Bodensteiner23/Weather_Station/BOMs/bom_RTC_Module.csv

Designator | Footprint | Quantity | Value | LCSC Part #
BT1 | BatteryHolder_LINX_BAT-HLD-012-SMT | 1 | MY-1220-03
C1, C2 | 0805 | 2 | 1uF/10V
C3 | 0603 | 1 | 100nF/10V
C4, C5 | 0603 | 2 | 12p5/10V
D1 | D_SOD-123 | 1 | MM1Z4V7
F1 | 0603 | 1 | F0603FA0500V063TM
J1 | PinHeader_1x06_P2.54mm_Horizontal | 1 | DZ254W-11-06-65
R1, R2, R3, R4 | 0603 | 4 | 4k7
U2 | SOIC-8_3.9x4.9mm_P1.27mm | 1 | PCF8563T
U3 | SOT-23-3 | 1 | XC6206P332MR-G
Y1 | Crystal_SMD_MicroCrystal_CC7V-T1A-2Pin_3.2x1.5mm | 1 | Q13FC13500004
