Bodensteiner23/Weather_Station/BOMs/bom_Solar_Module.csv

Designator | Footprint | Quantity | Value | LCSC Part #
C1, C2 | 0805 | 2 | 22u/16V
C3, C4 | 0805 | 2 | 10u/16V
D1 | D_SMA | 1 | SS54
D2, D3 | 0603 | 2 | LED
F1 | 0603 | 1 | CFS06V3T1R0
J1, J3 | JST_EH_B2B-EH-A_1x02_P2.50mm_Vertical | 2 | B2B-PH-K-S
J2 | USB_C_Receptacle_GCT_USB4105-xx-A_16P_TopMnt_Horizontal | 1 | TYPE-C16PIN
L1 | L_Sunlord_MWSA0603S | 1 | MDA7030-150M
R1 | 0603 | 1 | 750k
R2 | 0603 | 1 | 100k
R3 | 0603 | 1 | 4k
R4 | 0603 | 1 | 1k
R6, R7 | 0603 | 2 | 5k1
R8 | 0603 | 1 | 1M
U1 | SOT-23-6 | 1 | MT3608
U2 | SOT-23-6 | 1 | TP4057
