Bodensteiner23/Weather_Station/Step Files/DMB0006A.stp

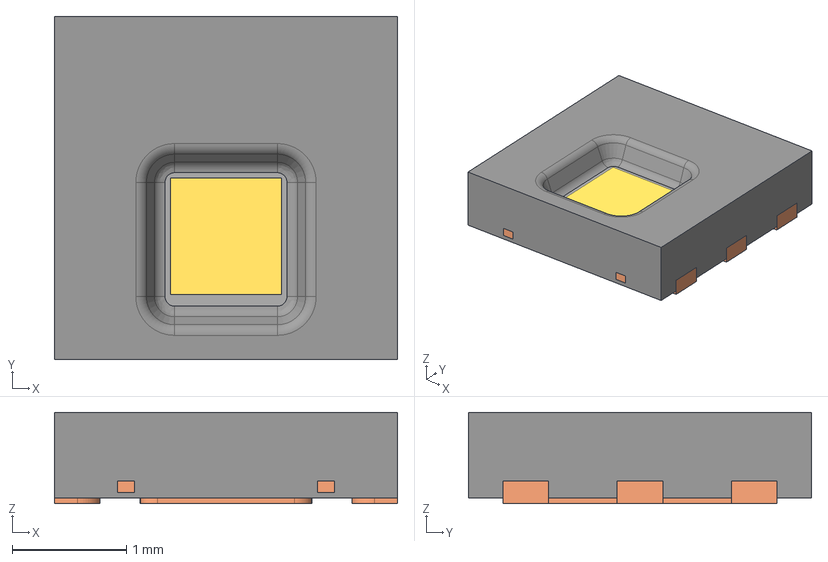
[picture p2: CAD file, 2024-08-01]
Step Files/DMB0006A.stp
3.00 x 3.00 x 0.8 mm
BODY-SON_118_1
FRAME-DMB0006A_77_1_1
FRAME-DMB0006A_77_2_1
FRAME-DMB0006A_77_3_1
FRAME-DMB0006A_77_4_1
FRAME-DMB0006A_77_5_1
FRAME-DMB0006A_77_6_1
FRAME-DMB0006A_77_7_1
PIN1-ID_16_1
DIE_1_1
