Bodensteiner23/Weather_Station/Solar Module/V1.0/Solar_Module.kicad_pcb

## KiCad design Solar Module/V1.0/Solar_Module.kicad_pcb (2024-08-16)

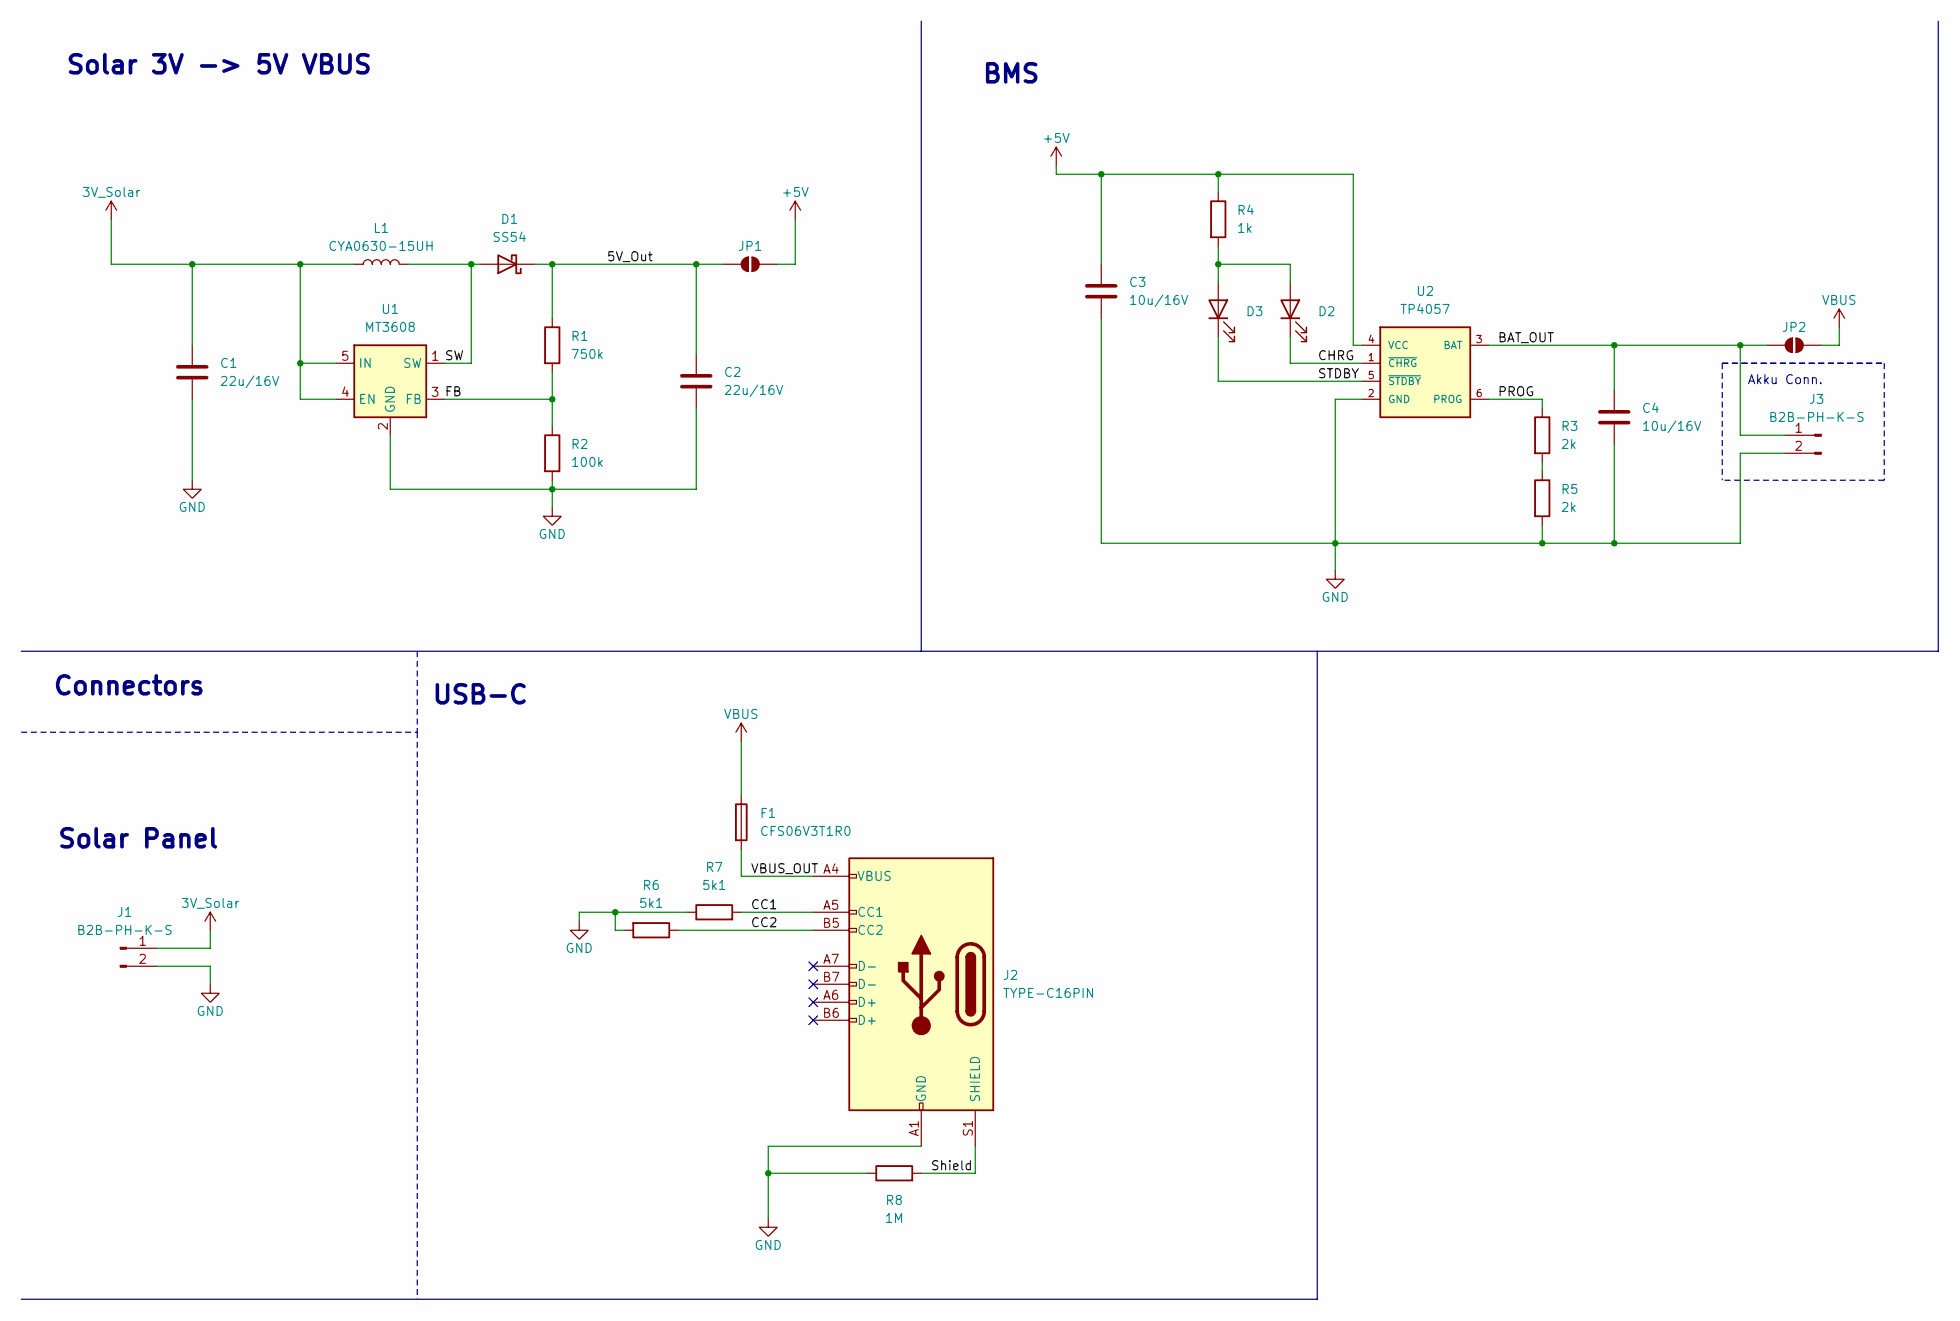
[picture p3: schematic Solar_Module.kicad_sch]

Parts:
C1, C2: 22u/16V; C_0805_2012Metric
C3, C4: 10u/16V; C_0805_2012Metric
D1: SS54; D_SMA
D2: KT-0603G; LED_0603_1608Metric
D3: KT-0603R; LED_0603_1608Metric
F1: CFS06V3T1R0; Fuse_0603_1608Metric
J1, J3: B2B-PH-K-S; JST_EH_B2B-EH-A_1x02_P2.50mm_Vertical
J2: TYPE-C16PIN; USB_C_Receptacle_GCT_USB4105-xx-A_16P_TopMnt_Horizontal
JP1, JP2: SolderJumper_2_Open; SolderJumper-2_P1.3mm_Open_TrianglePad1.0x1.5mm
L1: CYA0630-15UH; L_Chilisin_BMRx00060615
R1: 750k; R_0603_1608Metric
R2: 100k; R_0603_1608Metric
R3, R5: 2k; R_0603_1608Metric
R4: 1k; R_0603_1608Metric
R6, R7: 5k1; R_0603_1608Metric
R8: 1M; R_0603_1608Metric
U1: MT3608; SOT-23-6
U2: TP4057; SOT-23-6

Connections:
3V_Solar: C1.1, J1.1, L1.1, U1.4 (EN), U1.5 (IN)
+5V: C3.1, JP1.2 (B), R4.1, U2.4 (VCC)
/5V_Out: C2.1, D1.1 (K), JP1.1 (A), R1.1
/BAT_OUT: C4.1, J3.1, JP2.1 (A), U2.3 (BAT)
/CC1: J2.A5 (CC1), R7.2
/CC2: J2.B5 (CC2), R6.1
/CHRG: D2.1 (K), U2.1 (~CHRG)
/FB: R1.2, R2.1, U1.3 (FB)
/PROG: R3.1, U2.6 (PROG)
/STDBY: D3.1 (K), U2.5 (~STDBY)
/SW: D1.2 (A), L1.2, U1.1 (SW)
/Shield: J2.S1 (SHIELD), R8.2
/VBUS_OUT: F1.2, J2.A4 (VBUS), J2.A9 (VBUS), J2.B4 (VBUS), J2.B9 (VBUS)
GND: C1.2, C2.2, C3.2, C4.2, J1.2, J2.A1 (GND), J2.A12 (GND), J2.B1 (GND), J2.B12 (GND), J3.2, R2.2, R5.2, R6.2, R7.1, R8.1, U1.2 (GND), U2.2 (GND)
unnamed: D2.2 (A), D3.2 (A), R4.2
unnamed: R3.2, R5.1
VBUS: F1.1, JP2.2 (B)

Notes on the sheet:
Solar Panel
Connectors
Akku Conn.
USB-C
BMS
Solar 3V -> 5V VBUS

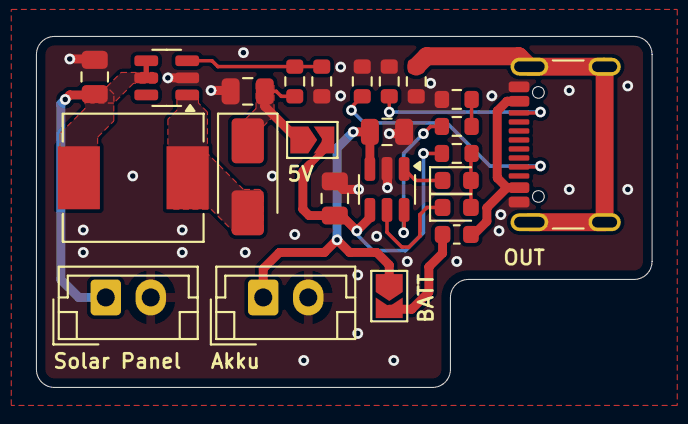
[picture p4: board Solar_Module.kicad_pcb from above]

Board: 4 copper layers, 34.2 x 19.5 mm, 24 parts (0 on the bottom side), 17 nets.
