Bodensteiner23/Weather_Station/Main PCB/V1.0/PCB_Files/Weather_Station.kicad_pcb

## KiCad design Main PCB/V1.0/PCB_Files/Weather_Station.kicad_pcb (2024-08-05, an earlier design)

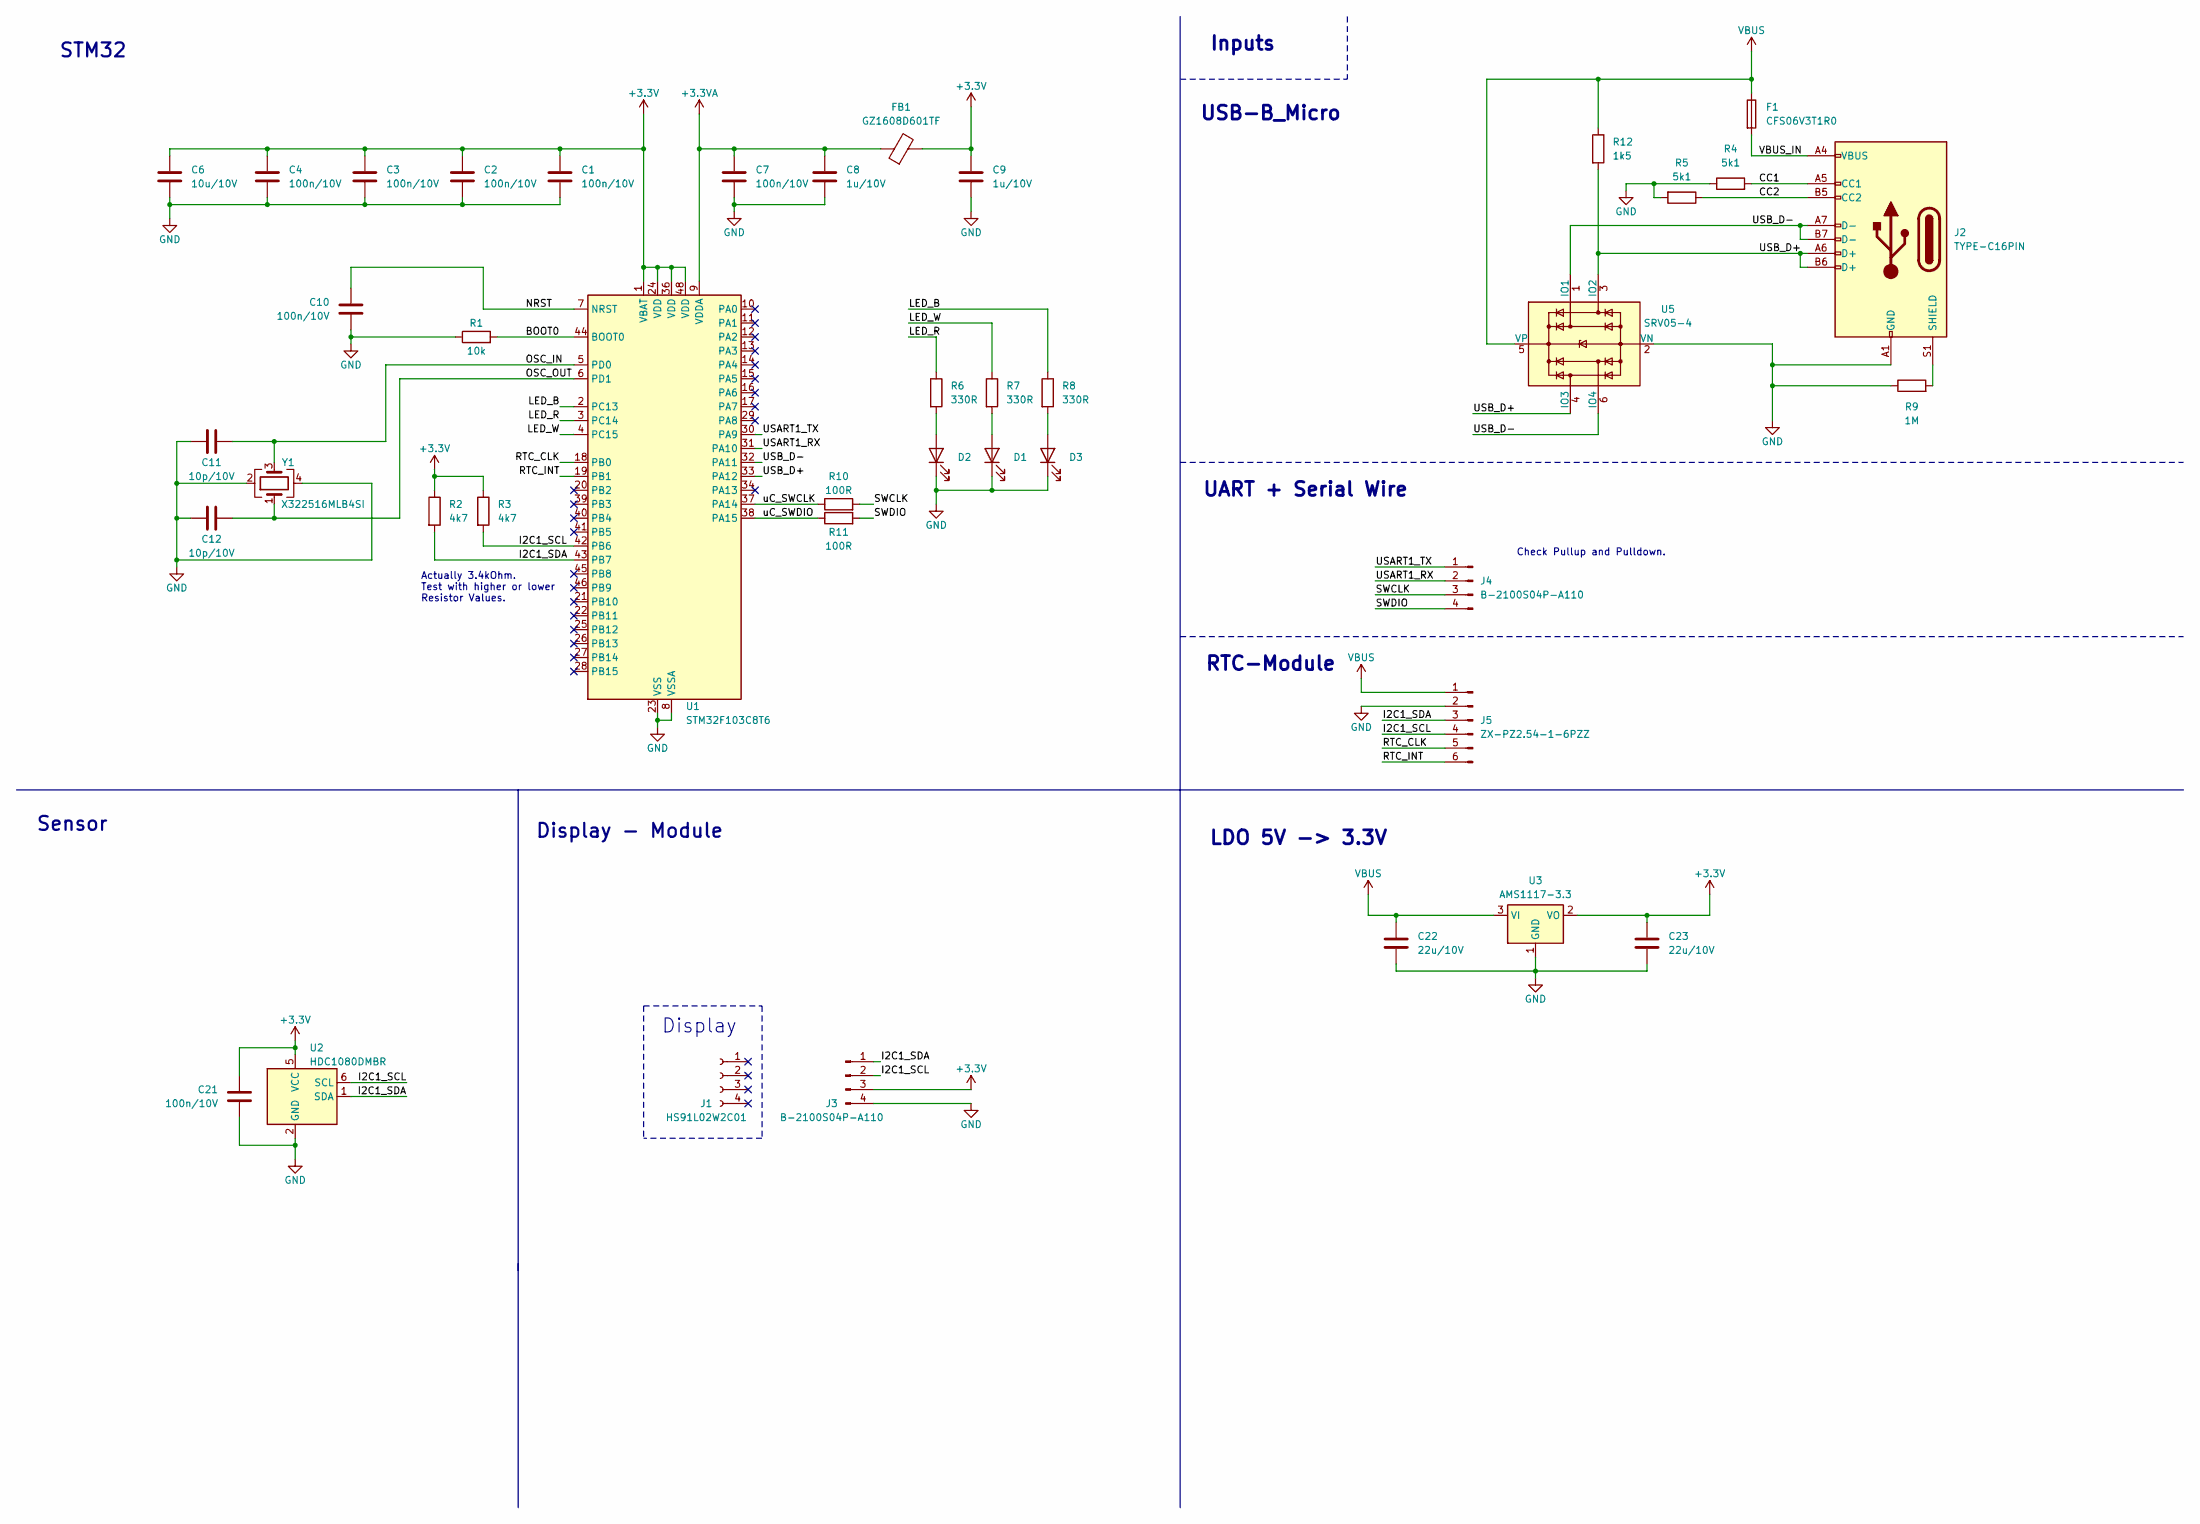
[picture p5: schematic Weather_Station.kicad_sch]

Parts:
C1, C2, C3, C4, C7, C10, C21: 100n/10V; C_0603_1608Metric
C6: 10u/10V; C_0805_2012Metric
C8, C9: 1u/10V; C_0603_1608Metric
C11, C12: 10p/10V; C_0603_1608Metric
C22, C23: 22u/10V; C_0805_2012Metric
D1: KT-0603W; LED_0603_1608Metric
D2: KT-0603R; LED_0603_1608Metric
D3: 19-217/BHC-ZL1M2RY/6T; LED_0603_1608Metric
F1: CFS06V3T1R0; Fuse_0603_1608Metric
FB1: GZ1608D601TF; L_1206_3216Metric
J1: HS91L02W2C01; C_0402_1005Metric
J2: TYPE-C16PIN; USB_C_Receptacle_GCT_USB4105-xx-A_16P_TopMnt_Horizontal
J3, J4: B-2100S04P-A110; PinHeader_1x04_P2.54mm_Vertical
J5: ZX-PZ2.54-1-6PZZ; PinHeader_1x06_P2.54mm_Vertical
R1: 10k; R_0603_1608Metric
R2, R3: 4k7; R_0603_1608Metric
R4, R5: 5k1; R_0603_1608Metric
R6, R7, R8: 330R; R_0603_1608Metric
R9: 1M; R_0603_1608Metric
R10, R11: 100R; R_0603_1608Metric
R12: 1k5; R_0603_1608Metric
U1: STM32F103C8T6; LQFP-48_7x7mm_P0.5mm
U2: HDC1080DMBR; Texas_PWSON-N6
U3: AMS1117-3.3; SOT-223-3_TabPin2
U5: SRV05-4; SOT-23-6
Y1: X322516MLB4SI; Crystal_SMD_3225-4Pin_3.2x2.5mm

Connections:
+3.3V: C1.1, C2.1, C3.1, C4.1, C6.1, C9.1, C21.2, C23.1, FB1.2, J3.3, R2.1, R3.1, U1.1 (VBAT), U1.24 (VDD), U1.36 (VDD), U1.48 (VDD), U2.5 (VCC), U3.2 (VO)
+3.3VA: C7.1, C8.1, FB1.1, U1.9 (VDDA)
/BOOT0: R1.2, U1.44 (BOOT0)
/CC1: J2.A5 (CC1), R4.2
/CC2: J2.B5 (CC2), R5.1
/I2C1_SCL: J3.2, J5.4, R3.2, U1.42 (PB6), U2.6 (SCL)
/I2C1_SDA: J3.1, J5.3, R2.2, U1.43 (PB7), U2.1 (SDA)
/LED_B: R8.1, U1.2 (PC13)
/LED_R: R6.1, U1.3 (PC14)
/LED_W: R7.1, U1.4 (PC15)
/NRST: C10.2, U1.7 (NRST)
/OSC_IN: C11.2, U1.5 (PD0), Y1.3
/OSC_OUT: C12.2, U1.6 (PD1), Y1.1
/RTC_CLK: J5.5, U1.18 (PB0)
/RTC_INT: J5.6, U1.19 (PB1)
/SWCLK: J4.3, R10.2
/SWDIO: J4.4, R11.2
/USART1_RX: J4.2, U1.31 (PA10)
/USART1_TX: J4.1, U1.30 (PA9)
/USB_D+: J2.A6 (D+), J2.B6 (D+), R12.2, U1.33 (PA12), U5.3 (IO2), U5.4 (IO3)
/USB_D-: J2.A7 (D-), J2.B7 (D-), U1.32 (PA11), U5.1 (IO1), U5.6 (IO4)
/VBUS_IN: F1.2, J2.A4 (VBUS), J2.A9 (VBUS), J2.B4 (VBUS), J2.B9 (VBUS)
/uC_SWCLK: R10.1, U1.37 (PA14)
/uC_SWDIO: R11.1, U1.38 (PA15)
GND: C1.2, C2.2, C3.2, C4.2, C6.2, C7.2, C8.2, C9.2, C10.1, C11.1, C12.1, C21.1, C22.2, C23.2, D1.1 (K), D2.1 (K), D3.1 (K), J2.A1 (GND), J2.A12 (GND), J2.B1 (GND), J2.B12 (GND), J3.4, J5.2, R1.1, R4.1, R5.2, R9.1, U1.8 (VSSA), U1.23 (VSS), U1.35 (VSS), U1.47 (VSS), U2.2 (GND), U3.1 (GND), U5.2 (VN), Y1.2, Y1.4
unnamed: D1.2 (A), R7.2
unnamed: D2.2 (A), R6.2
unnamed: D3.2 (A), R8.2
unnamed: J2.S1 (SHIELD), R9.2
VBUS: C22.1, F1.1, J5.1, R12.1, U3.3 (VI), U5.5 (VP)

Notes on the sheet:
Inputs
Actually 3.4kOhm. Test with higher or lower Resistor Values.
Display - Module
STM32
Display
Sensor
LDO 5V -> 3.3V
USB-B_Micro
RTC-Module
UART + Serial Wire
Check Pullup and Pulldown.

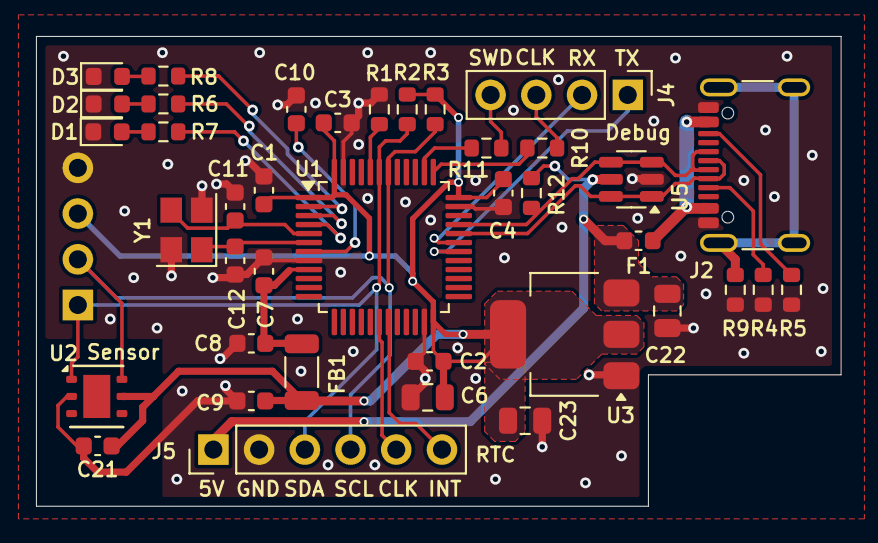
[picture p6: board Weather_Station.kicad_pcb from above]

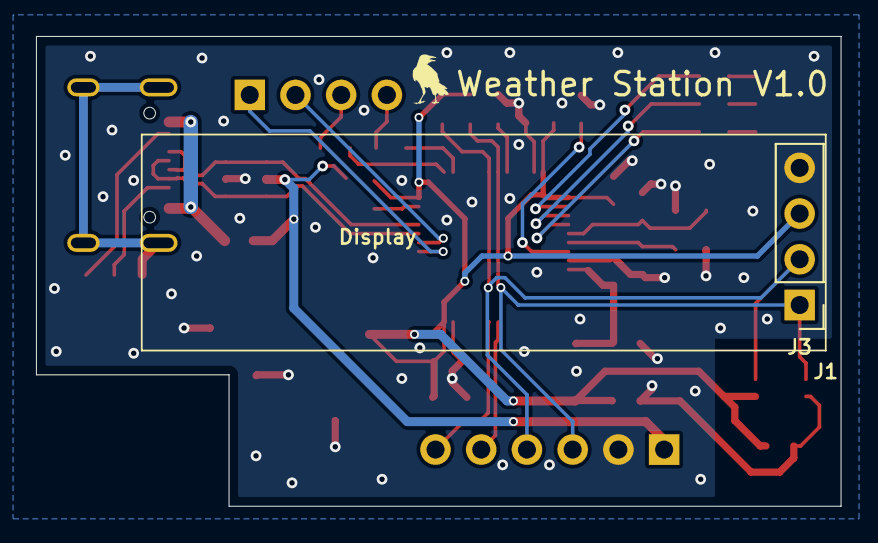
[picture p7: board Weather_Station.kicad_pcb from below]

Board: 4 copper layers, 44.7 x 26.1 mm, 41 parts (2 on the bottom side), 30 nets.
