Bodensteiner23/Weather_Station/(commit log)

2024-07-30 Initall commit of project.
    [Weather_Station.kicad_pcb, Weather_Station.kicad_sch]
2024-07-30 Finished pricipal routing of STM32F103.
    [Weather_Station.kicad_sch]
2024-07-30 Added STM32 Fiormware Directory + Prj. . Added OSC.
    [Weather_Station.kicad_sch]
2024-07-31 Some changes in the IOC and continues Schematic.
    [Weather_Station.kicad_sch]
2024-07-31 Display Wiring should be finsihed.
    [Weather_Station.kicad_sch]
2024-07-31 Now Display should be finished.
    [Weather_Station.kicad_sch]
2024-07-31 Just added input capacitor to sensor.
    [Weather_Station.kicad_sch]
2024-08-01 Added Step File of Sensor. USB Section should be finished and be ready for design.
    [DMB0006A.stp, Weather_Station.kicad_pcb, Weather_Station.kicad_sch]
2024-08-01 Updated Schematic with corrected TVS section.
    [Weather_Station.kicad_pcb, Weather_Station.kicad_sch]
2024-08-01 Now wiring of USB should be correct.
    [Weather_Station.kicad_sch]
2024-08-01 Schematic should be 90% finished. Finishing touches and then design review.
    [Weather_Station.kicad_pcb, Weather_Station.kicad_sch]
2024-08-01 Weird schematic error fixed.
    [Weather_Station.kicad_pcb, Weather_Station.kicad_sch]
2024-08-01 Added Debug Leds.
    [Weather_Station.kicad_sch]
2024-08-01 Started Layout of PCB.
    [Weather_Station.kicad_pcb, Weather_Station.kicad_sch]
2024-08-01 Made Progress with STM32 Layout.
    [Weather_Station.kicad_pcb, Weather_Station.kicad_sch]
2024-08-02 Changed USART1 to USART3. Finished LDO Layout. Finished ESD protection of micro USB.
    [Weather_Station.kicad_sch]
2024-08-02 Changed back to USART_1.
    [Weather_Station.kicad_sch]
2024-08-02 Questions for Schwering now.
    [Weather_Station.kicad_pcb]
2024-08-04 Decided to not go with the display. Added Step file for display.
    [OLED_0.91_128x32.stp, Weather_Station.kicad_pcb, Weather_Station.kicad_sch]
2024-08-04 Should be final component placement.
    [Weather_Station.kicad_pcb]
2024-08-04 Finished first version of routing.
    [Weather_Station.kicad_pcb, Weather_Station.kicad_sch]
2024-08-04 Changed Micro USB to USB.
    [Weather_Station.kicad_pcb, Weather_Station.kicad_sch]
2024-08-04 Routing of V1 should be finsihed.
    [Weather_Station.kicad_pcb]
2024-08-04 V1.0 should be finished.
    [Weather_Station.kicad_pcb, Weather_Station.kicad_sch, bom.csv, designators.csv, positions.csv]
2024-08-04 DRC is to do but otherwise should be V1.
    [Weather_Station.kicad_pcb, Weather_Station.kicad_sch, bom.csv]
2024-08-05 Changed Fuse and added SWD Restistor.
    [Weather_Station.kicad_pcb, Weather_Station.kicad_sch]
2024-08-06 Added v2 of project.
    [Weather_Station.kicad_pcb, Weather_Station.kicad_sch]
2024-08-06 Progressed with much more cleaner design.
    [Weather_Station.kicad_pcb, Weather_Station.kicad_sch]
2024-08-06 Made Progress with Design of V2.
    [Weather_Station.kicad_pcb]
2024-08-06 Nearly finished V2.
    [Weather_Station.kicad_pcb]
2024-08-06 V2 nerly finished. Round corners / DRC need to be done.
    [Weather_Station.kicad_pcb]
2024-08-06 V2 should be finished!!
    [Weather_Station.kicad_pcb]
2024-08-06 This is ordered Version of Weather Station V2!!!
    [Weather_Station.kicad_pcb, Weather_Station.kicad_sch, bom.csv, designators.csv, positions.csv]
2024-08-07 Added ToDo for next Version.
    [Weather_Station.kicad_sch]
2024-08-07 Changed Directory and added sub directories for different pcbs.
    [Solar_Module.kicad_pcb, Solar_Module.kicad_sch, Weather_Station.kicad_pcb, Weather_Station.kicad_sch, bom.csv, designators.csv, positions.csv]
2024-08-07 Design of MT3608 Boost converter should be finished.
    [Solar_Module.kicad_sch]
2024-08-07 Added TP4057 to Schematic.
    [Solar_Module.kicad_sch]
2024-08-08 Updated Buck Converter Passives.
    [Solar_Module.kicad_pcb, Solar_Module.kicad_sch]
2024-08-08 Schematic of TP4057 should be finished.
    [Solar_Module.kicad_sch]
2024-08-08 Added Connector for Akku.
    [Solar_Module.kicad_sch]
2024-08-10 Added USB-C connector to schematic.
    [Solar_Module.kicad_pcb, Solar_Module.kicad_sch]
2024-08-10 Updated Schematics and nearly finished schematic.
    [Solar_Module.kicad_sch]
2024-08-10 Rough design of DCDC.
    [Solar_Module.kicad_pcb, Solar_Module.kicad_sch]
2024-08-10 Continued with layout of BMS IC.
    [Solar_Module.kicad_pcb]
2024-08-11 Progressed with Design. Now in a solid state.
    [Solar_Module.kicad_pcb]
2024-08-11 Design roughly finished. Now Routing.
    [Solar_Module.kicad_pcb]
2024-08-11 V1 Design nearly finished. Only Edges needed to be round.
    [Solar_Module.kicad_pcb]
2024-08-11 Design should be finished.
    [Solar_Module.kicad_pcb]
2024-08-12 Added Production files.
    [Solar_Module.kicad_sch, bom.csv, designators.csv, positions.csv]
2024-08-14 Added BOMS and added notes in schematic.
    [Merged_BOM_Main_Solar_RTC.xlsx, Solar_Module.kicad_sch, bom_Main_PCB.csv, bom_RTC_Module.csv, bom_Solar_Module.csv]
2024-08-16 Nothing really changed.
    [Solar_Module.csv, Solar_Module.kicad_pcb, Solar_Module.kicad_sch]
2024-08-16 Final Script
    [BOM_Main_PCB_RTC_Solar.xlsx, Merged_BOM_Main_Solar_RTC.xlsx, Merged_csv.csv]
2024-08-16 Final BOM.
    [BOM_Main_PCB_RTC_Solar.xlsx]
2024-08-16 This is ordered Version!!!
    [Solar_Module.kicad_sch]
